Leo-Silva-get/EEG-PCB-Design-Project/images/2D_Bottom.png

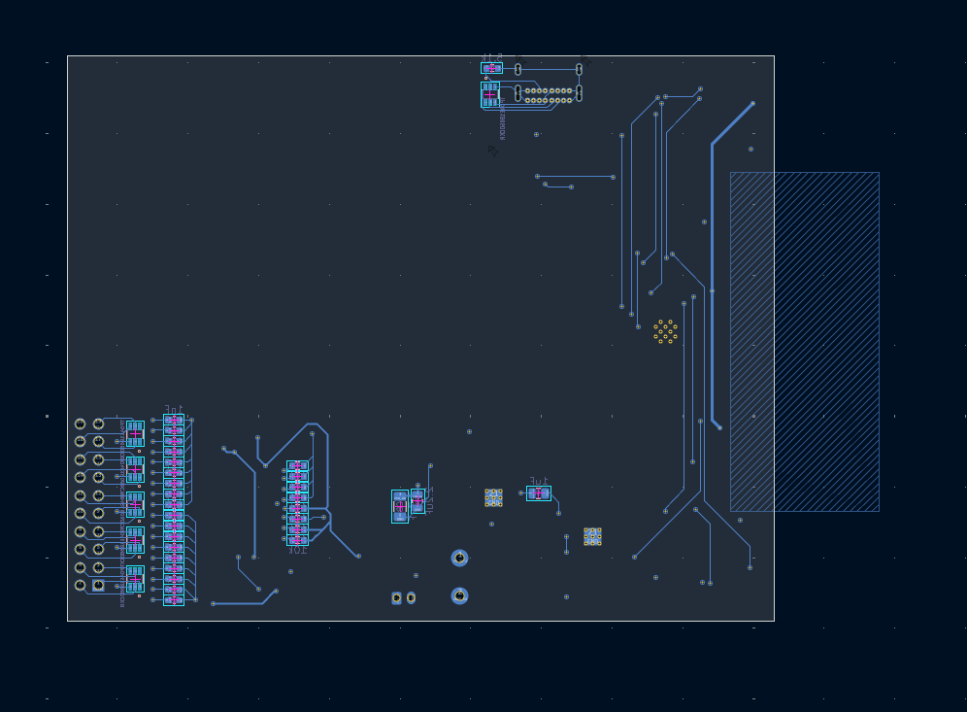
images/2D_Bottom.png
