Leo-Silva-get/EEG-PCB-Design-Project/images/2D_Top.png

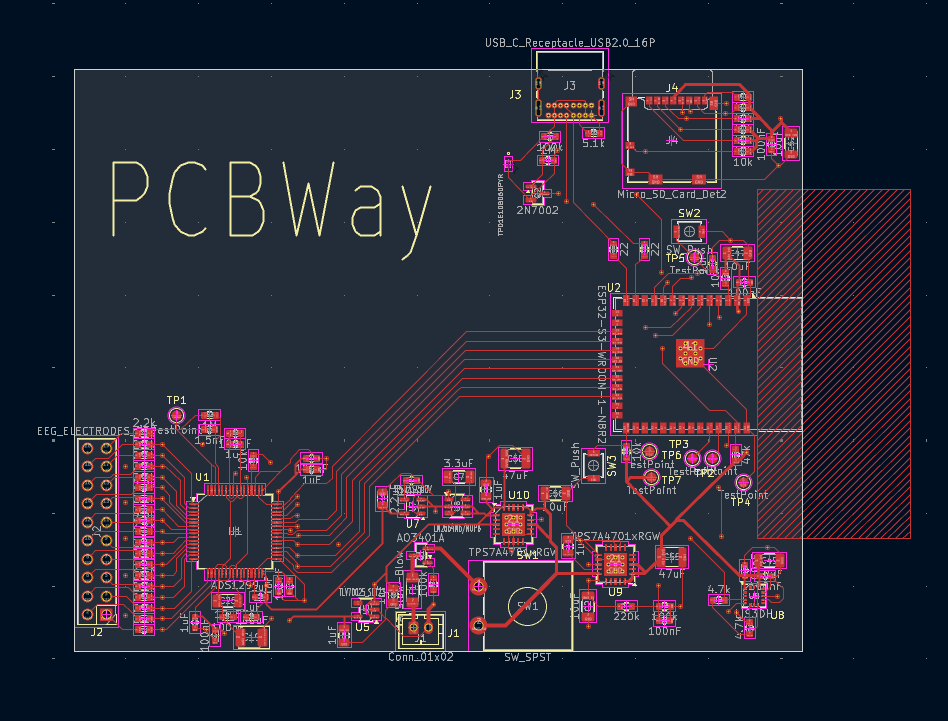
images/2D_Top.png
