Leo-Silva-get/EEG-PCB-Design-Project/images/3D_Bottom.png

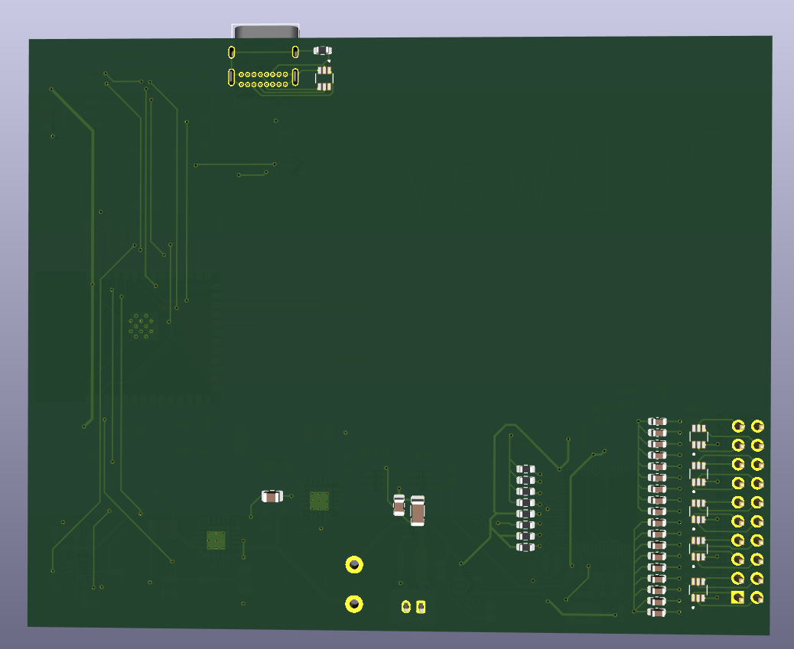
images/3D_Bottom.png
