Leo-Silva-get/EEG-PCB-Design-Project/images/3D_Top.png

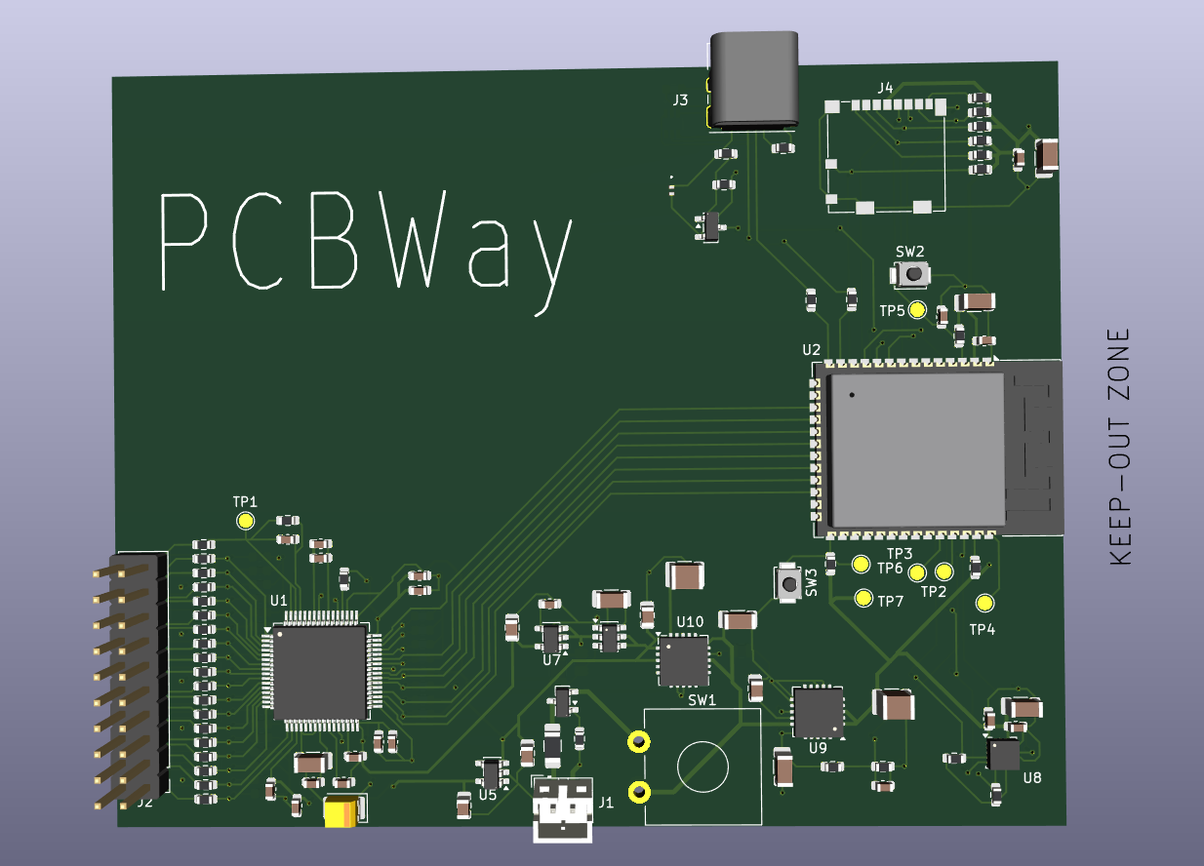
images/3D_Top.png
