Leo-Silva-get/EEG-PCB-Design-Project/images/Schematic_ADS1299_Sheet.png

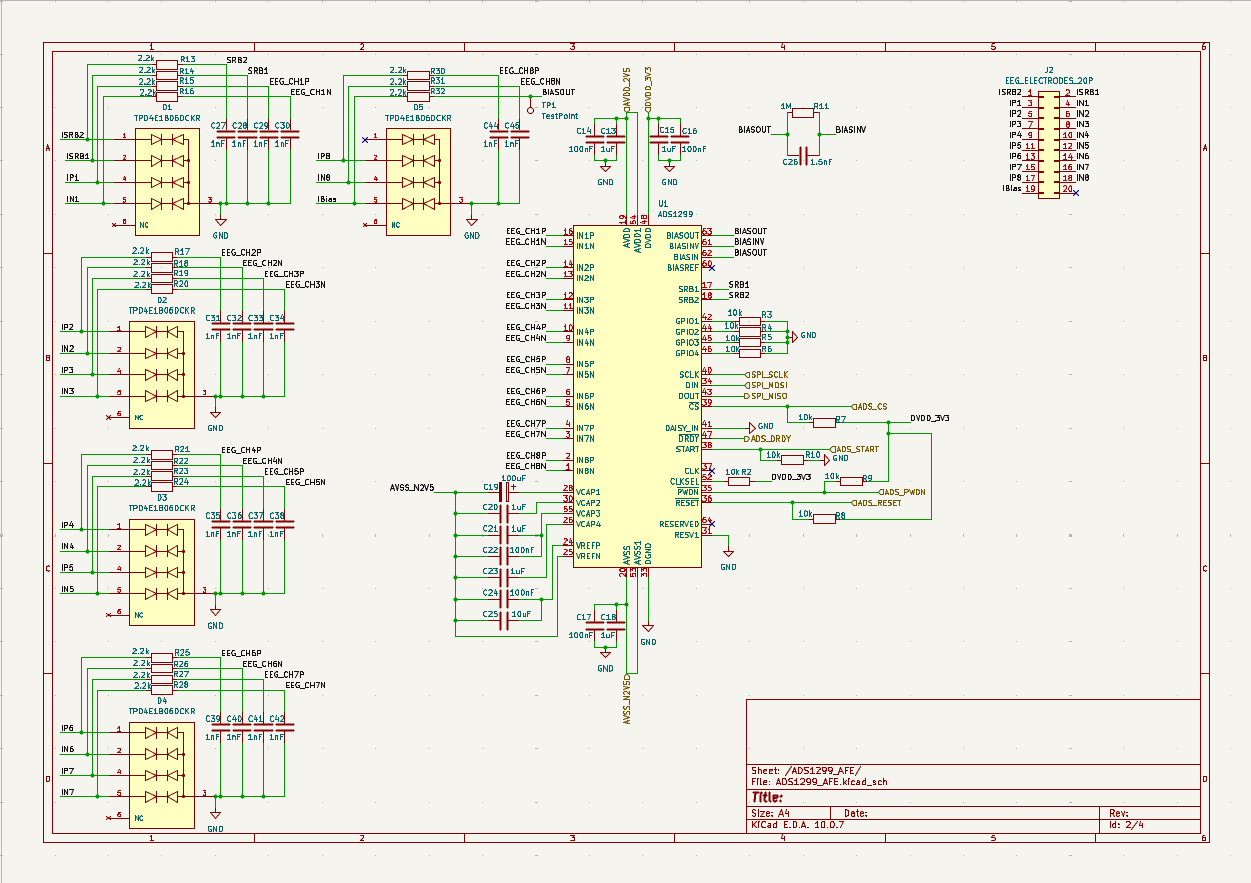
images/Schematic_ADS1299_Sheet.png
