Leo-Silva-get/EEG-PCB-Design-Project/images/Schematic_ESP32_Sheet.png

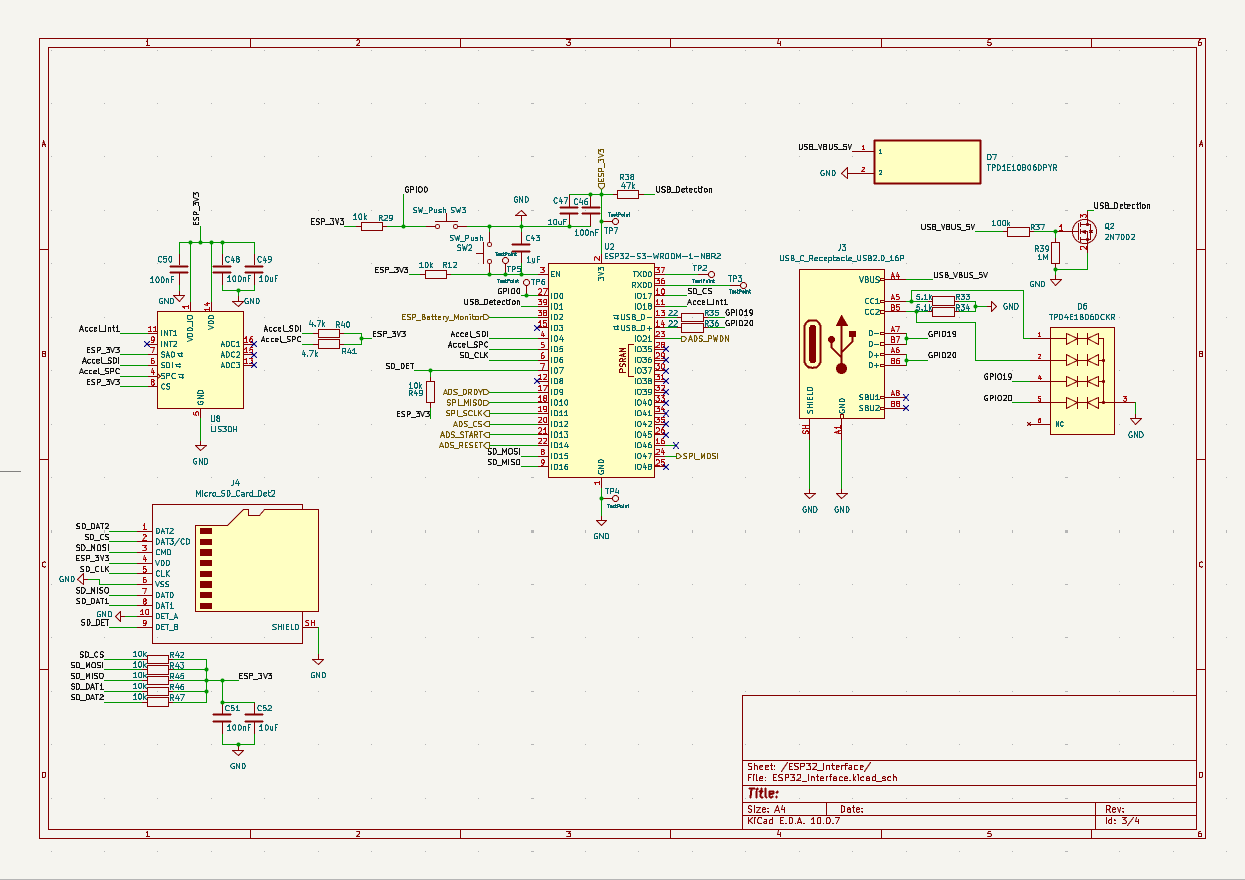
images/Schematic_ESP32_Sheet.png
