Leo-Silva-get/EEG-PCB-Design-Project/images/Schematic_PowerSupply_Sheet.png

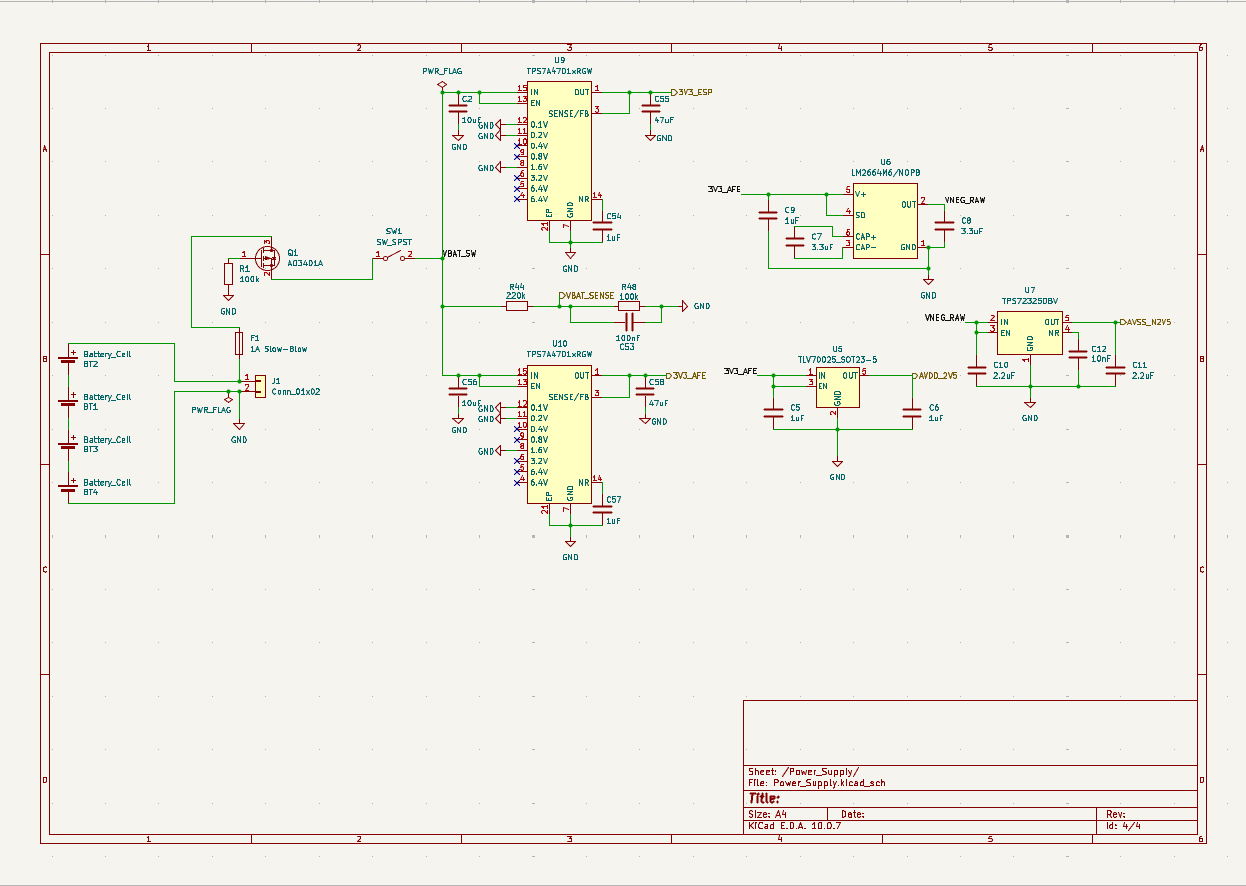
images/Schematic_PowerSupply_Sheet.png
