Leo-Silva-get/EEG-PCB-Design-Project/images/Schematic_Top_Level.png

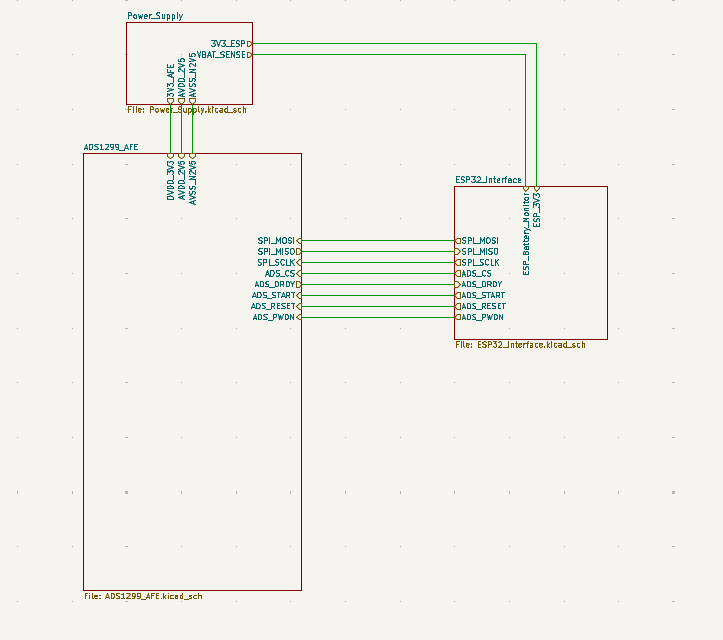
images/Schematic_Top_Level.png
