Leo-Silva-get/EEG-PCB-Design-Project/manufacturing/EEG_PROJECT_PCBWay_BOM_CLEANED.csv

Reference | Qty | Value | Manufacturer | MPN | Footprint | Assembly Type | Datasheet | Voltage Rating | Tolerance | Dielectric | Power Rating
C2, C25, C47, C49, C52, C56 | 6 | 10uF | Murata | GRM31CR71C106KAC7L | Capacitor_SMD:C_1206_3216Metric | Surface mount | https://www.digikey.com/en/products/detail/murata-electronics/GRM31CR71C106KAC7L/965995 | 16V | 10% | X7R ceramic
C5, C6, C9, C54, C57 | 5 | 1uF | TDK | C2012X7R1E105K125AB | Capacitor_SMD:C_0805_2012Metric | Surface mount | https://www.digikey.com/en/products/detail/tdk-corporation/C2012X7R1E105K125AB/513887 | 25V | 10% | X7R ceramic
C7, C8 | 2 | 3.3uF | KEMET | C1206C335K3RACTU | Capacitor_SMD:C_1206_3216Metric | Surface mount | https://www.digikey.com/en/products/detail/kemet/C1206C335K3RACTU/2215760 | 25V | 10% | X7R ceramic
C10, C11 | 2 | 2.2uF | TDK | C2012X7R1H225K125AC | Capacitor_SMD:C_0805_2012Metric | Surface mount | https://www.digikey.com/en/products/detail/tdk/C2012X7R1H225K125AC/2443446 | 50V | 10% | X7R ceramic
C12 | 1 | 10nF | Murata | GRM188R72A103KA01D | Capacitor_SMD:C_0603_1608Metric | Surface mount | https://www.digikey.com/en/products/detail/murata-electronics/GRM188R72A103KA01D/3845635 | 100V | 10% | X7R ceramic
C13, C15, C18, C20, C21, C23, C43 | 7 | 1uF | KEMET | C0603C105K4RACTU | Capacitor_SMD:C_0603_1608Metric | Surface mount | https://www.digikey.com/en/products/detail/kemet/C0603C105K4RACTU/2199788 | 16V | 10% | X7R ceramic
C14, C16, C17, C22, C24, C46, C48, C50, C51, C53 | 10 | 100nF | Murata | GRM188R72A104KA35D | Capacitor_SMD:C_0603_1608Metric | Surface mount | https://www.digikey.com/en/products/detail/murata-electronics/GRM188R72A104KA35D/702826 | 100V | 10% | X7R ceramic
C19 | 1 | 100uF | KEMET | T495B107M010ATE350 | Capacitor_Tantalum_SMD:CP_EIA-3528-21_Kemet-B | Surface mount | https://www.digikey.com/en/products/detail/kemet/T495B107M010ATE350/9642231 | 10V | 20% | Molded tantalum; ESR 0.35 Ω @100 kHz
C26 | 1 | 1.5nF | Murata | GRM1885C1H152JA01D | Capacitor_SMD:C_0603_1608Metric | Surface mount | https://www.digikey.com/en/products/detail/murata-electronics/GRM1885C1H152JA01D/587659 | 50V | 5% | C0G / NP0 ceramic
C27, C28, C29, C30, C31, C32, C33, C34, C35, C36, C37, C38, C39, C40, C41, C42, C44, C45 | 18 | 1nF | Murata | GRM1885C1H102JA01D | Capacitor_SMD:C_0603_1608Metric | Surface mount | https://www.digikey.com/en/products/detail/murata-electronics/GRM1885C1H102JA01D/587655 | 50V | 5% | C0G / NP0 ceramic
C55, C58 | 2 | 47uF | Samsung Electro-Mechanics | CL32A476KOJNNNE | Capacitor_SMD:C_1210_3225Metric | Surface mount | https://www.digikey.com/en/products/detail/samsung-electro-mechanics/CL32A476KOJNNNE/3889034 | 16V | 10% | X5R ceramic
D1, D2, D3, D4, D5, D6 | 6 | TPD4E1B06DCKR | Texas Instruments | TPD4E1B06DCKR | Library:TVS_TPD4E1B06DCKR | Surface mount | https://www.ti.com/product/TPD4E1B06 |  |  | ESD / TVS
D7 | 1 | TPD1E10B06DPYR | Texas Instruments | TPD1E10B06DPYR | Library:DIO_TPD1E10B06DPYR | Surface mount | https://www.ti.com/product/TPD1E10B06 |  |  | ESD / TVS
F1 | 1 | 1A Slow-Blow | Bourns | SF-1206S100-2 | Library:SF-1206S100-2 | Surface mount | https://www.bourns.com/docs/product-datasheets/sf-1206s.pdf |  |  | Slow-blow, non-resettable fuse
J1 | 1 | Conn_01x02 | JST | B2B-PH-K-S(LF)(SN) | Connector_JST:JST_PH_B2B-PH-K_1x02_P2.00mm_Vertical | Through-hole | https://www.digikey.com/en/products/detail/jst-sales-america-inc/B2B-PH-K-S-LF-SN/926611
J2 | 1 | EEG_ELECTRODES_20P | Samtec | TSW-110-07-G-D | Connector_PinHeader_2.54mm:PinHeader_2x10_P2.54mm_Vertical | Through-hole | https://www.digikey.com/en/products/detail/samtec-inc/TSW-110-07-G-D/1101267
J3 | 1 | USB_C_Receptacle_USB2.0_16P | GCT | USB4085-GF-A | Connector_USB:USB_C_Receptacle_GCT_USB4085 | Through-hole | https://www.digikey.com/en/products/detail/gct/USB4085-GF-A/9859662
J4 | 1 | Micro_SD_Card_Det2 | Molex | 104031-0811 | Connector_Card:microSD_HC_Molex_104031-0811 | Surface mount | https://www.digikey.com/en/products/detail/molex/1040310811/2370379
Q1 | 1 | AO3401A | Alpha & Omega Semiconductor | AO3401A | Package_TO_SOT_SMD:SOT-23 | Surface mount | https://www.digikey.com/en/products/detail/alpha-omega-semiconductor-inc/AO3401A/1855943 |  |  | SOT-23 MOSFET
Q2 | 1 | 2N7002 | Onsemi | 2N7002LT1G | Package_TO_SOT_SMD:SOT-23 | Surface mount | https://www.digikey.com/en/products/detail/onsemi/2N7002LT1G/917791 |  |  | SOT-23 MOSFET
R1, R37, R48 | 3 | 100k | YAGEO | RC0603FR-07100KL | Resistor_SMD:R_0603_1608Metric | Surface mount | https://www.digikey.com/en/products/detail/yageo/RC0603FR-07100KL/726889 | Max working voltage per YAGEO RC datasheet | ±1% | Thick-film chip resistor | 0.1 W
R2, R3, R4, R5, R6, R7, R8, R9, R10, R12, R29, R42, R43, R45, R46, R47, R49 | 17 | 10k | YAGEO | RC0603FR-0710KL | Resistor_SMD:R_0603_1608Metric | Surface mount | https://www.digikey.com/en/products/detail/yageo/RC0603FR-0710KL/729827 | Max working voltage per YAGEO RC datasheet | ±1% | Thick-film chip resistor | 0.1 W
R11, R39 | 2 | 1M | YAGEO | RC0603FR-071ML | Resistor_SMD:R_0603_1608Metric | Surface mount | https://www.digikey.com/en/products/detail/yageo/RC0603FR-071ML/729791 | Max working voltage per YAGEO RC datasheet | ±1% | Thick-film chip resistor | 0.1 W
R13, R14, R15, R16, R17, R18, R19, R20, R21, R22, R23, R24, R25, R26, R27, R28, R30, R31, R32 | 19 | 2.2k | YAGEO | RC0603FR-072K2L | Resistor_SMD:R_0603_1608Metric | Surface mount | https://www.digikey.com/en/products/detail/yageo/RC0603FR-072K2L/727016 | Max working voltage per YAGEO RC datasheet | ±1% | Thick-film chip resistor | 0.1 W
R33, R34 | 2 | 5.1k | YAGEO | RC0603FR-075K1L | Resistor_SMD:R_0603_1608Metric | Surface mount | https://www.digikey.com/en/products/detail/yageo/RC0603FR-075K1L/727268 | Max working voltage per YAGEO RC datasheet | ±1% | Thick-film chip resistor | 0.1 W
R35, R36 | 2 | 22 | YAGEO | RC0603FR-0722RL | Resistor_SMD:R_0603_1608Metric | Surface mount | https://www.digikey.com/en/products/detail/yageo/RC0603FR-0722RL/727055 | Max working voltage per YAGEO RC datasheet | ±1% | Thick-film chip resistor | 0.1 W
R38 | 1 | 47k | YAGEO | RC0603FR-0747KL | Resistor_SMD:R_0603_1608Metric | Surface mount | https://www.digikey.com/en/products/detail/yageo/RC0603FR-0747KL/730200 | Max working voltage per YAGEO RC datasheet | ±1% | Thick-film chip resistor | 0.1 W
R40, R41 | 2 | 4.7k | YAGEO | RC0603FR-074K7L | Resistor_SMD:R_0603_1608Metric | Surface mount | https://www.digikey.com/en/products/detail/yageo/RC0603FR-074K7L/727212 | Max working voltage per YAGEO RC datasheet | ±1% | Thick-film chip resistor | 0.1 W
R44 | 1 | 220k | YAGEO | RC0603FR-07220KL | Resistor_SMD:R_0603_1608Metric | Surface mount | https://www.digikey.com/en/products/detail/yageo/RC0603FR-07220KL/727062 | Max working voltage per YAGEO RC datasheet | ±1% | Thick-film chip resistor | 0.1 W
SW1 | 1 | SW_SPST | CW Industries | GPTS203211B | Button_Switch_THT:SW_CW_GPTS203211B | Through-hole | https://www.digikey.com/en/products/detail/cw-industries/GPTS203211B/CW181-ND/3190590 |  |  | Electromechanical switch
SW2, SW3 | 2 | SW_Push | Aratas (formerly Omron Components) | B3U-1000P | Button_Switch_SMD:SW_SPST_B3U-1000P | Surface mount | https://www.digikey.com/en/products/detail/omron-electronics-inc-emc-div/B3U-1000P/1534338 |  |  | Electromechanical switch
U1 | 1 | ADS1299 | Texas Instruments | ADS1299IPAG | Package_QFP:TQFP-64_10x10mm_P0.5mm | Surface mount | https://www.ti.com/lit/ds/symlink/ads1299.pdf
U2 | 1 | ESP32-S3-WROOM-1-N8R2 | Espressif | ESP32-S3-WROOM-1-N8R2 | RF_Module:ESP32-S3-WROOM-1 | Surface mount | https://www.espressif.com/sites/default/files/documentation/esp32-s3-wroom-1_wroom-1u_datasheet_en.pdf
U5 | 1 | TLV70025_SOT23-5 | Texas Instruments | TLV70025DDCR | Package_TO_SOT_SMD:SOT-23-5 | Surface mount | https://www.digikey.com/en/products/detail/texas-instruments/TLV70025DDCR/2261946
U6 | 1 | LM2664M6/NOPB | Texas Instruments | LM2664M6/NOPB | Package_TO_SOT_SMD:SOT-23-6 | Surface mount | https://www.ti.com/lit/ds/symlink/lm2664.pdf
U7 | 1 | TPS72325DBV | Texas Instruments | TPS72325DBVR | Package_TO_SOT_SMD:SOT-23-5 | Surface mount | https://www.ti.com/lit/ds/symlink/tps723.pdf
U8 | 1 | LIS3DH | STMicroelectronics | LIS3DHTR | Package_LGA:LGA-16_3x3mm_P0.5mm_LayoutBorder3x5y | Surface mount | https://www.digikey.com/en/products/detail/stmicroelectronics/LIS3DHTR/2334338
U9, U10 | 2 | TPS7A4701xRGW | Texas Instruments | TPS7A4701RGWR | Package_DFN_QFN:Texas_RGW0020A_VQFN-20-1EP_5x5mm_P0.65mm_EP3.15x3.15mm_ThermalVias | Surface mount | https://www.ti.com/product/TPS7A47/part-details/TPS7A4701RGWR
