Leo-Silva-get/EEG-PCB-Design-Project/manufacturing/EEG_PROJECT-B_Fab.pdf

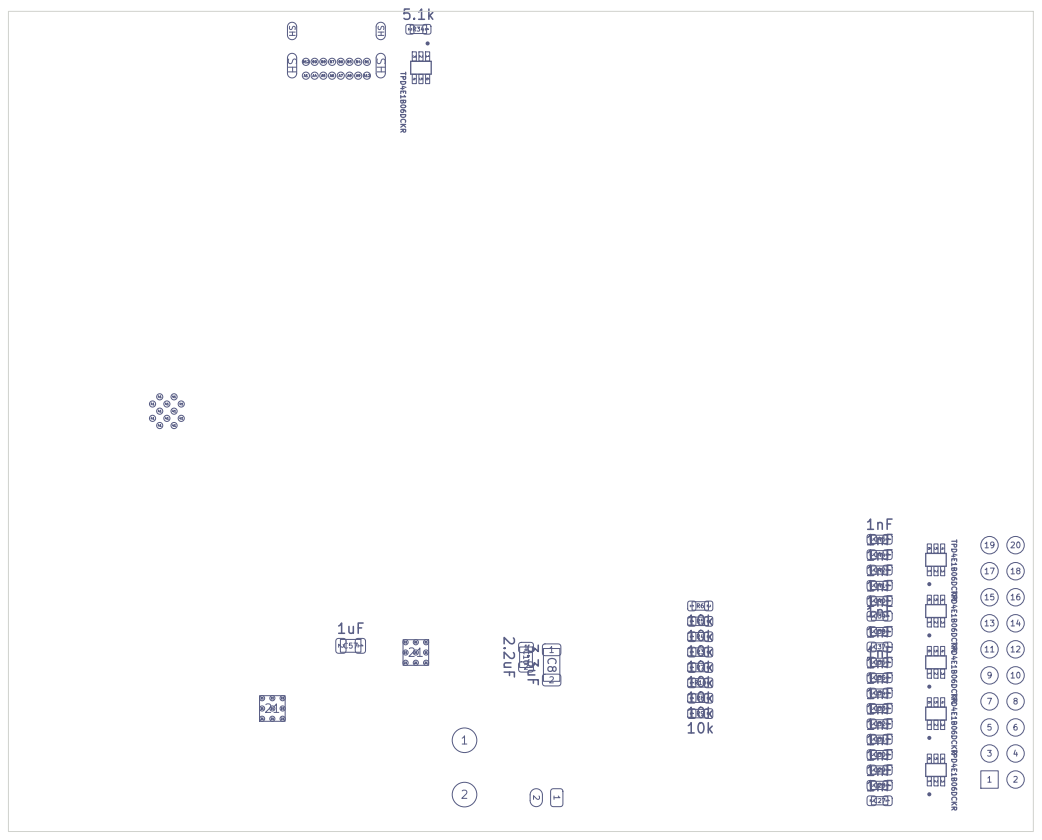
[picture p9: page 1]
