Leo-Silva-get/EEG-PCB-Design-Project/manufacturing/EEG_PROJECT-F_Fab.pdf

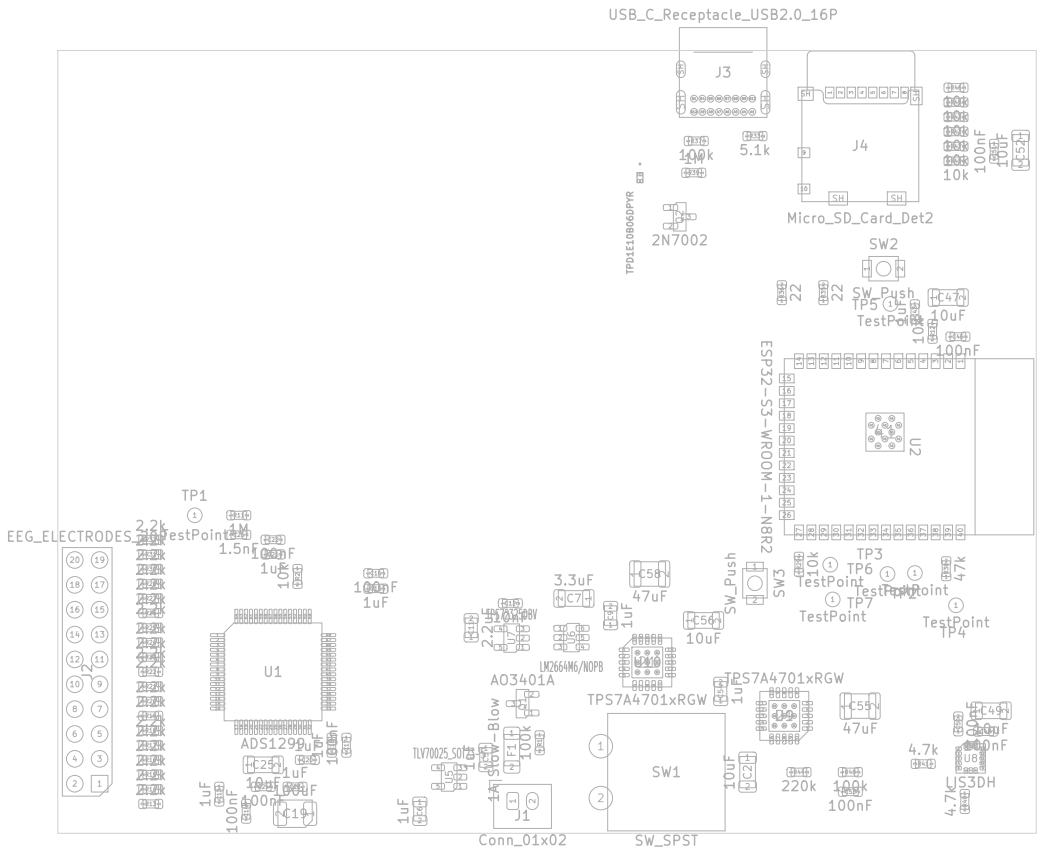
[picture p10: page 1]
