Leo-Silva-get/EEG-PCB-Design-Project/manufacturing/EEG_Project.pdf

J3


C38 5.1k

R34
