Leo-Silva-get/EEG-PCB-Design-Project/hardware/EEG_PROJECT.kicad_pcb

## KiCad design hardware/EEG_PROJECT.kicad_pcb (2026-11-08)

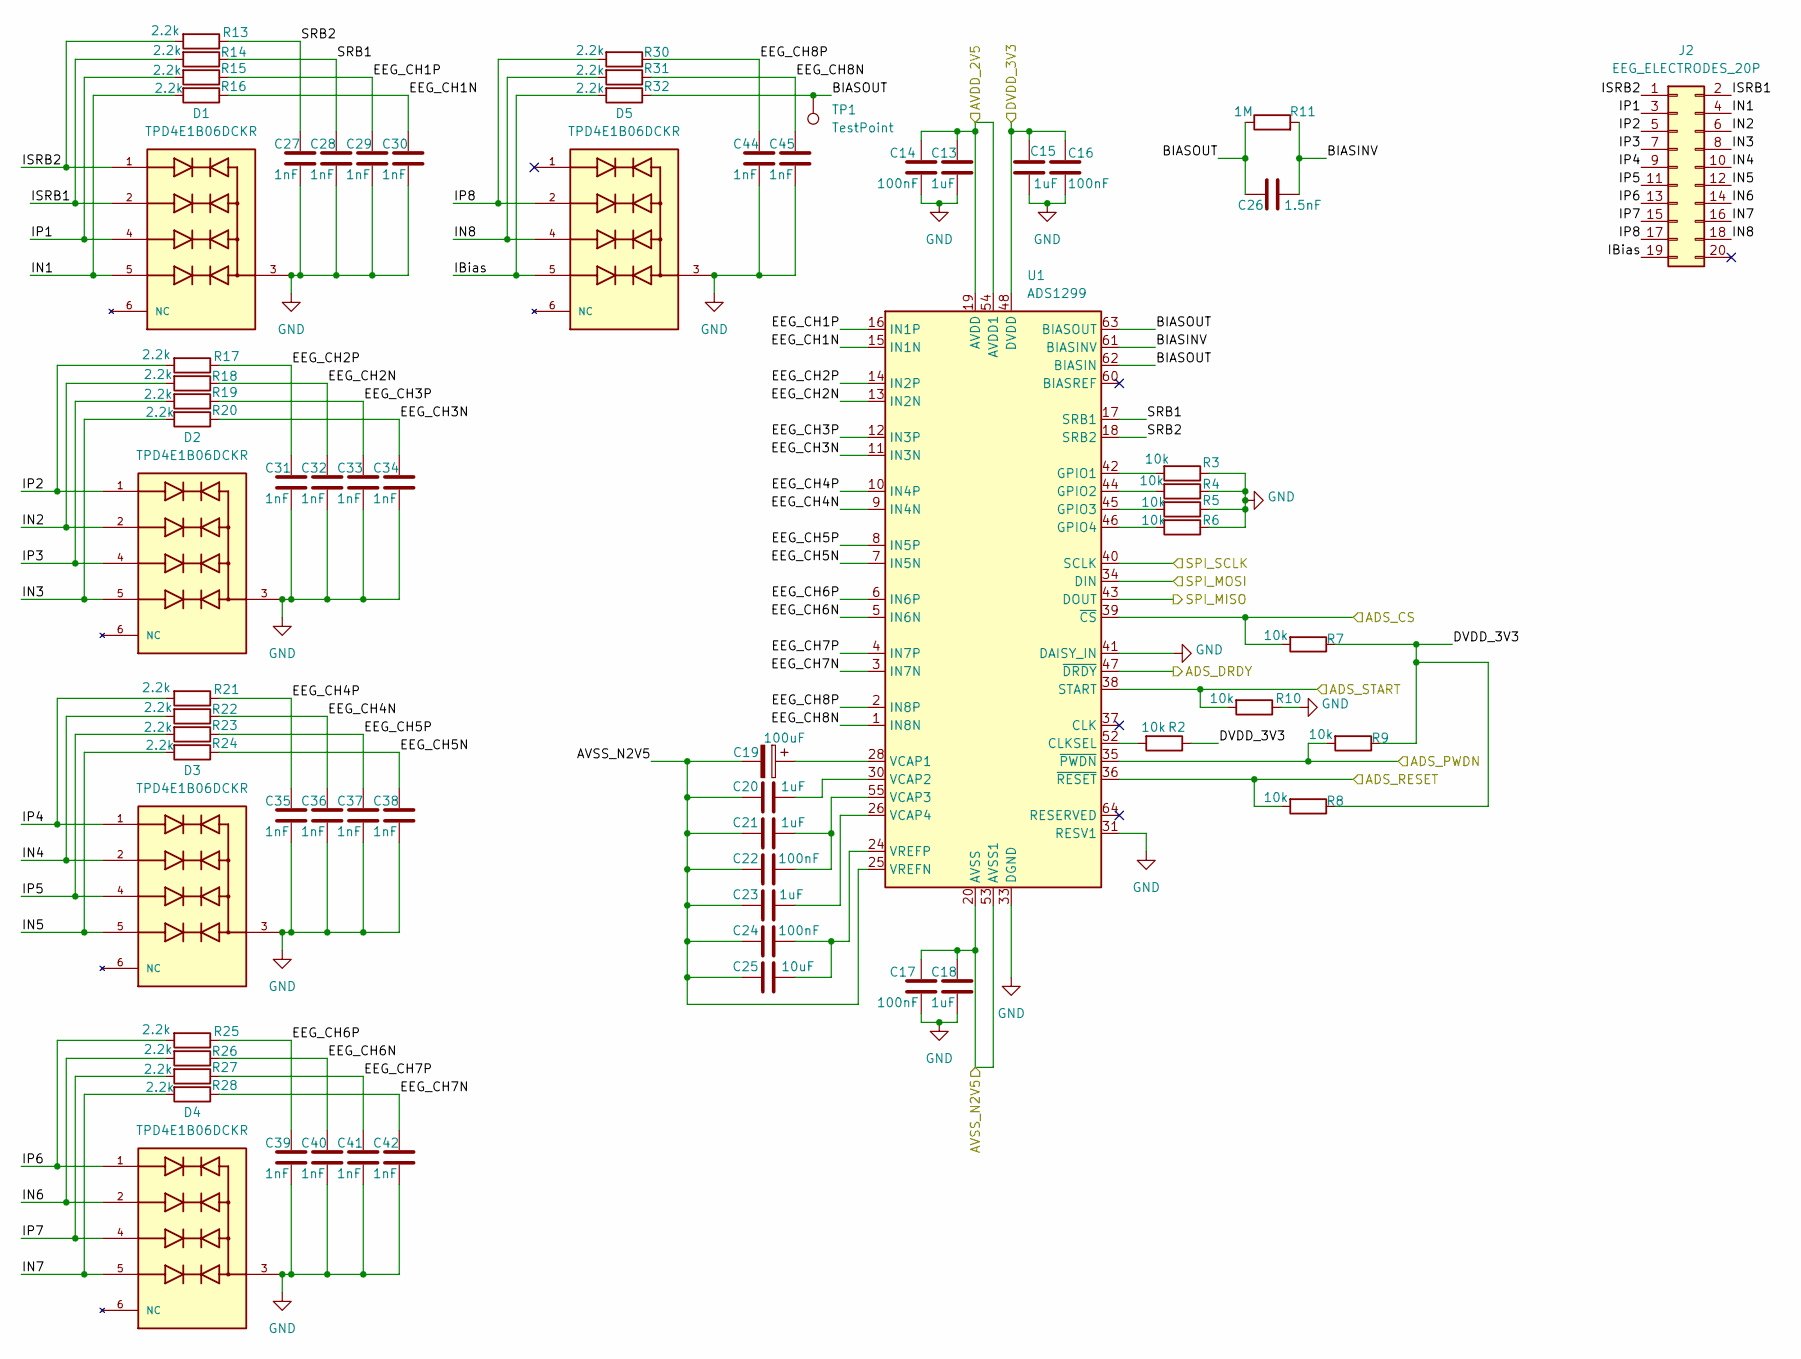
[picture p11: schematic ADS1299_AFE.kicad_sch]

Parts:
C13, C15, C18, C20, C21, C23: 1uF; C_0603_1608Metric; Tolerance 10%; Voltage rating 16V; MPN C0603C105K4RACTU
C14, C16, C17, C22, C24: 100nF; C_0603_1608Metric; Tolerance 10%; Voltage rating 100V; MPN GRM188R72A104KA35D
C19: 100uF; CP_EIA-3528-21_Kemet-B; Tolerance 20%; Voltage rating 10V; MPN T495B107M010ATE350
C25: 10uF; C_1206_3216Metric; Tolerance 10%; Voltage rating 16V; MPN GRM31CR71C106KAC7L
C26: 1.5nF; C_0603_1608Metric; Tolerance 5%; Voltage rating 50V; MPN GRM1885C1H152JA01D
C27, C28, C29, C30, C31, C32, C33, C34, C35, C36, C37, C38, C39, C40, C41, C42, C44, C45: 1nF; C_0603_1608Metric; Tolerance 5%; Voltage rating 50V; MPN GRM1885C1H102JA01D
D1, D2, D3, D4, D5: TPD4E1B06DCKR; TVS_TPD4E1B06DCKR; PARTREV C
J2: EEG_ELECTRODES_20P; PinHeader_2x10_P2.54mm_Vertical; MPN TSW-110-07-G-D
R2, R3, R4, R5, R6, R7, R8, R9, R10: 10k; R_0603_1608Metric; Power Rating 0.1 W; Tolerance ±1%; MPN RC0603FR-0710KL
R11: 1M; R_0603_1608Metric; Power Rating 0.1 W; Tolerance ±1%; MPN RC0603FR-071ML
R13, R14, R15, R16, R17, R18, R19, R20, R21, R22, R23, R24, R25, R26, R27, R28, R30, R31, R32: 2.2k; R_0603_1608Metric; Power Rating 0.1 W; Tolerance ±1%; MPN RC0603FR-072K2L
TP1: TestPoint; TestPoint_Pad_D1.5mm; MPN N/A
U1: ADS1299; TQFP-64_10x10mm_P0.5mm; MPN ADS1299IPAG

Connections:
/ADS1299_AFE/ADS_CS: R7.2, U1.39 (~CS); also elsewhere on the board
/ADS1299_AFE/ADS_DRDY: U1.47 (~DRDY); also elsewhere on the board
/ADS1299_AFE/ADS_PWDN: R9.2, U1.35 (~PWDN); also elsewhere on the board
/ADS1299_AFE/ADS_RESET: R8.2, U1.36 (~RESET); also elsewhere on the board
/ADS1299_AFE/ADS_START: R10.2, U1.38 (START); also elsewhere on the board
/ADS1299_AFE/AVDD_2V5: C13.1, C14.1, U1.19 (AVDD), U1.21 (AVDD), U1.22 (AVDD), U1.54 (AVDD1), U1.56 (AVDD), U1.59 (AVDD); also elsewhere on the board
/ADS1299_AFE/AVSS_N2V5: C17.1, C18.1, C19.2, C20.1, C21.1, C22.1, C23.1, C24.1, C25.1, U1.20 (AVSS), U1.23 (AVSS), U1.25 (VREFN), U1.32 (AVSS), U1.53 (AVSS1), U1.57 (AVSS), U1.58 (AVSS); also elsewhere on the board
/ADS1299_AFE/BIASINV: C26.2, R11.2, U1.61 (BIASINV)
/ADS1299_AFE/BIASOUT: C26.1, R11.1, R32.1, TP1.1 (1_1), U1.62 (BIASIN), U1.63 (BIASOUT)
/ADS1299_AFE/DVDD_3V3: C15.1, C16.1, R2.1, R7.1, R8.1, R9.1, U1.48 (DVDD), U1.50 (DVDD); also elsewhere on the board
/ADS1299_AFE/EEG_CH1N: C30.1, R16.1, U1.15 (IN1N)
/ADS1299_AFE/EEG_CH1P: C29.1, R15.1, U1.16 (IN1P)
/ADS1299_AFE/EEG_CH2N: C32.1, R18.1, U1.13 (IN2N)
/ADS1299_AFE/EEG_CH2P: C31.1, R17.1, U1.14 (IN2P)
/ADS1299_AFE/EEG_CH3N: C34.1, R20.1, U1.11 (IN3N)
/ADS1299_AFE/EEG_CH3P: C33.1, R19.1, U1.12 (IN3P)
/ADS1299_AFE/EEG_CH4N: C36.1, R22.1, U1.9 (IN4N)
/ADS1299_AFE/EEG_CH4P: C35.1, R21.1, U1.10 (IN4P)
/ADS1299_AFE/EEG_CH5N: C38.1, R24.1, U1.7 (IN5N)
/ADS1299_AFE/EEG_CH5P: C37.1, R23.1, U1.8 (IN5P)
/ADS1299_AFE/EEG_CH6N: C40.1, R26.1, U1.5 (IN6N)
/ADS1299_AFE/EEG_CH6P: C39.1, R25.1, U1.6 (IN6P)
/ADS1299_AFE/EEG_CH7N: C42.1, R28.1, U1.3 (IN7N)
/ADS1299_AFE/EEG_CH7P: C41.1, R27.1, U1.4 (IN7P)
/ADS1299_AFE/EEG_CH8N: C45.1, R31.1, U1.1 (IN8N)
/ADS1299_AFE/EEG_CH8P: C44.1, R30.1, U1.2 (IN8P)
/ADS1299_AFE/IBias: D5.5, J2.19, R32.2
/ADS1299_AFE/IN1: D1.5, J2.4, R16.2
/ADS1299_AFE/IN2: D2.2, J2.6, R18.2
/ADS1299_AFE/IN3: D2.5, J2.8, R20.2
/ADS1299_AFE/IN4: D3.2, J2.10, R22.2
/ADS1299_AFE/IN5: D3.5, J2.12, R24.2
/ADS1299_AFE/IN6: D4.2, J2.14, R26.2
/ADS1299_AFE/IN7: D4.5, J2.16, R28.2
/ADS1299_AFE/IN8: D5.4, J2.18, R31.2
/ADS1299_AFE/IP1: D1.4, J2.3, R15.2
/ADS1299_AFE/IP2: D2.1, J2.5, R17.2
/ADS1299_AFE/IP3: D2.4, J2.7, R19.2
/ADS1299_AFE/IP4: D3.1, J2.9, R21.2
/ADS1299_AFE/IP5: D3.4, J2.11, R23.2
/ADS1299_AFE/IP6: D4.1, J2.13, R25.2
/ADS1299_AFE/IP7: D4.4, J2.15, R27.2
/ADS1299_AFE/IP8: D5.2, J2.17, R30.2
/ADS1299_AFE/ISRB1: D1.2, J2.2, R14.2
/ADS1299_AFE/ISRB2: D1.1, J2.1, R13.2
/ADS1299_AFE/SPI_MISO: U1.43 (DOUT); also elsewhere on the board
/ADS1299_AFE/SPI_MOSI: U1.34 (DIN); also elsewhere on the board
/ADS1299_AFE/SPI_SCLK: U1.40 (SCLK); also elsewhere on the board
/ADS1299_AFE/SRB1: C28.1, R14.1, U1.17 (SRB1)
/ADS1299_AFE/SRB2: C27.1, R13.1, U1.18 (SRB2)
GND: C13.2, C14.2, C15.2, C16.2, C17.2, C18.2, C27.2, C28.2, C29.2, C30.2, C31.2, C32.2, C33.2, C34.2, C35.2, C36.2, C37.2, C38.2, C39.2, C40.2, C41.2, C42.2, C44.2, C45.2, D1.3, D2.3, D3.3, D4.3, D5.3, R3.1, R4.1, R5.1, R6.1, R10.1, U1.31 (RESV1), U1.33 (DGND), U1.41 (DAISY_IN), U1.49 (DGND), U1.51 (DGND); also elsewhere on the board
unnamed: R2.2, U1.52 (CLKSEL)
unnamed: R3.2, U1.42 (GPIO1)
unnamed: R4.2, U1.44 (GPIO2)
unnamed: R5.2, U1.45 (GPIO3)
unnamed: R6.2, U1.46 (GPIO4)
unnamed: C19.1, U1.28 (VCAP1)
unnamed: C20.2, U1.30 (VCAP2)
unnamed: C21.2, C22.2, U1.55 (VCAP3)
unnamed: C23.2, U1.26 (VCAP4)
unnamed: C24.2, C25.2, U1.24 (VREFP)

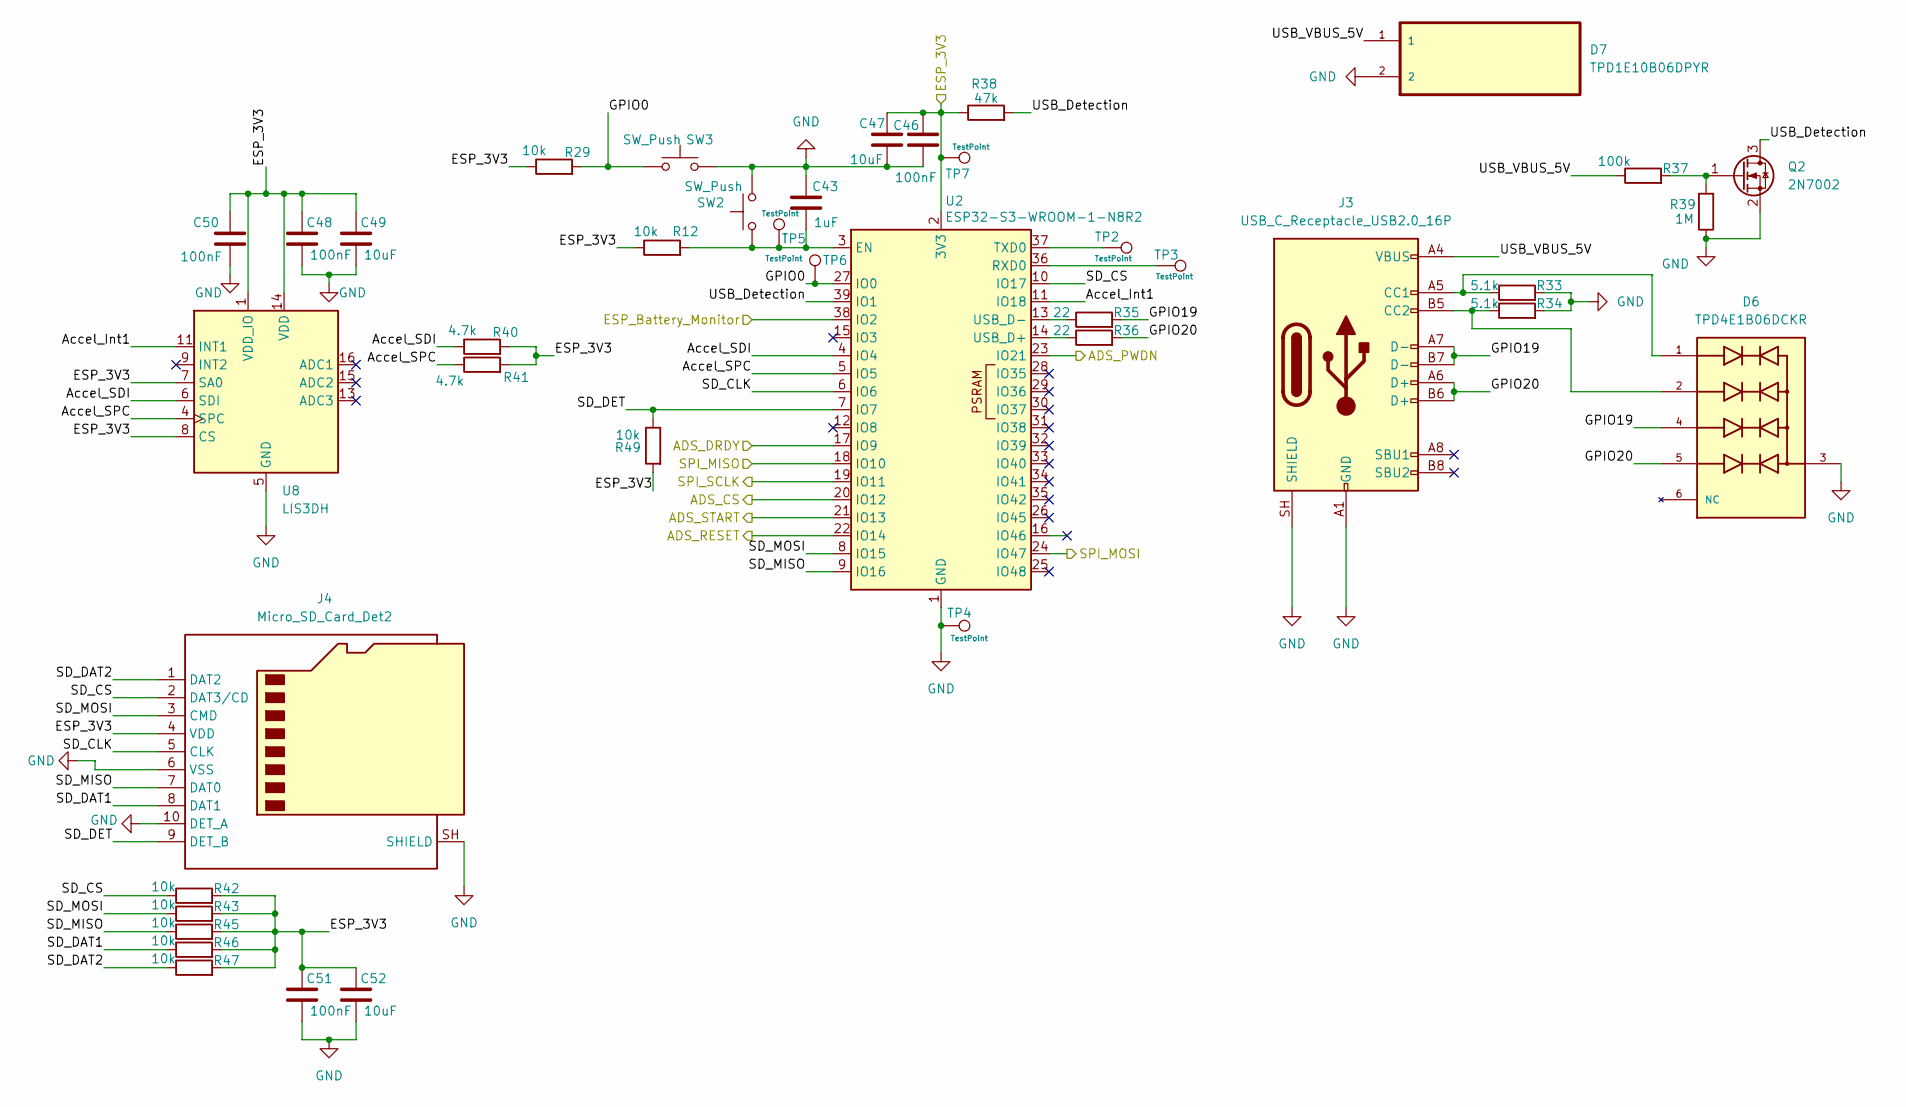
[picture p12: schematic ESP32_Interface.kicad_sch]

Parts:
C43: 1uF; C_0603_1608Metric; Tolerance 10%; Voltage rating 16V; MPN C0603C105K4RACTU
C46, C48, C50, C51: 100nF; C_0603_1608Metric; Tolerance 10%; Voltage rating 100V; MPN GRM188R72A104KA35D
C47, C49, C52: 10uF; C_1206_3216Metric; Tolerance 10%; Voltage rating 16V; MPN GRM31CR71C106KAC7L
D6: TPD4E1B06DCKR; TVS_TPD4E1B06DCKR; PARTREV C
D7: TPD1E10B06DPYR; DIO_TPD1E10B06DPYR; MPN TPD1E10B06DPYR; DigiKey_Part_Number 296-41842-1-ND
J3: USB_C_Receptacle_USB2.0_16P; USB_C_Receptacle_GCT_USB4085; MPN USB4085-GF-A
J4: Micro_SD_Card_Det2; microSD_HC_Molex_104031-0811; MPN 104031-0811
Q2: 2N7002; SOT-23; MPN 2N7002LT1G
R12, R29, R42, R43, R45, R46, R47, R49: 10k; R_0603_1608Metric; Power Rating 0.1 W; Tolerance ±1%; MPN RC0603FR-0710KL
R33, R34: 5.1k; R_0603_1608Metric; Power Rating 0.1 W; Tolerance ±1%; MPN RC0603FR-075K1L
R35, R36: 22; R_0603_1608Metric; Power Rating 0.1 W; Tolerance ±1%; MPN RC0603FR-0722RL
R37: 100k; R_0603_1608Metric; Power Rating 0.1 W; Tolerance ±1%; MPN RC0603FR-07100KL
R38: 47k; R_0603_1608Metric; Power Rating 0.1 W; Tolerance ±1%; MPN RC0603FR-0747KL
R39: 1M; R_0603_1608Metric; Power Rating 0.1 W; Tolerance ±1%; MPN RC0603FR-071ML
R40, R41: 4.7k; R_0603_1608Metric; Power Rating 0.1 W; Tolerance ±1%; MPN RC0603FR-074K7L
SW2, SW3: SW_Push; SW_SPST_B3U-1000P; MPN B3U-1000P
TP2, TP3, TP4, TP5, TP6, TP7: TestPoint; TestPoint_Pad_D1.5mm; MPN N/A
U2: ESP32-S3-WROOM-1-N8R2; ESP32-S3-WROOM-1; MPN ESP32-S3-WROOM-1-N8R2
U8: LIS3DH; LGA-16_3x3mm_P0.5mm_LayoutBorder3x5y; MPN LIS3DHTR

Connections:
/ADS1299_AFE/ADS_CS: U2.20 (IO12); also elsewhere on the board
/ADS1299_AFE/ADS_DRDY: U2.17 (IO9); also elsewhere on the board
/ADS1299_AFE/ADS_PWDN: U2.23 (IO21); also elsewhere on the board
/ADS1299_AFE/ADS_RESET: U2.22 (IO14); also elsewhere on the board
/ADS1299_AFE/ADS_START: U2.21 (IO13); also elsewhere on the board
/ADS1299_AFE/SPI_MISO: U2.18 (IO10); also elsewhere on the board
/ADS1299_AFE/SPI_MOSI: U2.24 (IO47); also elsewhere on the board
/ADS1299_AFE/SPI_SCLK: U2.19 (IO11); also elsewhere on the board
/ESP32_Interface/Accel_Int1: U2.11 (IO18), U8.11 (INT1)
/ESP32_Interface/Accel_SDI: R40.1, U2.4 (IO4), U8.6 (SDI)
/ESP32_Interface/Accel_SPC: R41.1, U2.5 (IO5), U8.4 (SPC)
/ESP32_Interface/ESP_3V3: C46.1, C47.1, C48.1, C49.1, C50.1, C51.1, C52.1, J4.4 (VDD), R12.1, R29.1, R38.1, R40.2, R41.2, R42.2, R43.2, R45.2, R46.2, R47.2, R49.2, TP7.1 (1_1), U2.2 (3V3), U8.1 (VDD_IO), U8.7 (SA0), U8.8 (CS), U8.14 (VDD); also elsewhere on the board
/ESP32_Interface/ESP_Battery_Monitor: U2.38 (IO2); also elsewhere on the board
/ESP32_Interface/GPIO0: R29.2, SW3.1, TP6.1 (1_1), U2.27 (IO0)
/ESP32_Interface/GPIO19: D6.4, J3.A7 (D-), J3.B7 (D-), R35.2
/ESP32_Interface/GPIO20: D6.5, J3.A6 (D+), J3.B6 (D+), R36.2
/ESP32_Interface/SD_CLK: J4.5 (CLK), U2.6 (IO6)
/ESP32_Interface/SD_CS: J4.2 (DAT3/CD), R42.1, U2.10 (IO17)
/ESP32_Interface/SD_DAT1: J4.8 (DAT1), R46.1
/ESP32_Interface/SD_DAT2: J4.1 (DAT2), R47.1
/ESP32_Interface/SD_DET: J4.9 (DET_B), R49.1, U2.7 (IO7)
/ESP32_Interface/SD_MISO: J4.7 (DAT0), R45.1, U2.9 (IO16)
/ESP32_Interface/SD_MOSI: J4.3 (CMD), R43.1, U2.8 (IO15)
/ESP32_Interface/USB_Detection: Q2.3 (D), R38.2, U2.39 (IO1)
/ESP32_Interface/USB_VBUS_5V: D7.1, J3.A4 (VBUS), J3.A9 (VBUS), J3.B4 (VBUS), J3.B9 (VBUS), R37.1
GND: C43.1, C46.2, C47.2, C48.2, C49.2, C50.2, C51.2, C52.2, D6.3, D7.2, J3.A1 (GND), J3.A12 (GND), J3.B1 (GND), J3.B12 (GND), J3.SH (SHIELD), J4.6 (VSS), J4.10 (DET_A), J4.SH (SHIELD), Q2.2 (S), R33.2, R34.2, R39.1, SW2.2, SW3.2, TP4.1 (1_1), U2.1 (GND), U2.40 (GND), U2.41 (GND), U8.5 (GND), U8.10 (GND), U8.12 (GND); also elsewhere on the board
unnamed: D6.1, J3.A5 (CC1), R33.1
unnamed: D6.2, J3.B5 (CC2), R34.1
unnamed: Q2.1 (G), R37.2, R39.2
unnamed: C43.2, R12.2, SW2.1, TP5.1 (1_1), U2.3 (EN)
unnamed: TP3.1 (1_1), U2.36 (RXD0)
unnamed: TP2.1 (1_1), U2.37 (TXD0)
unnamed: R36.1, U2.14 (USB_D+)
unnamed: R35.1, U2.13 (USB_D-)

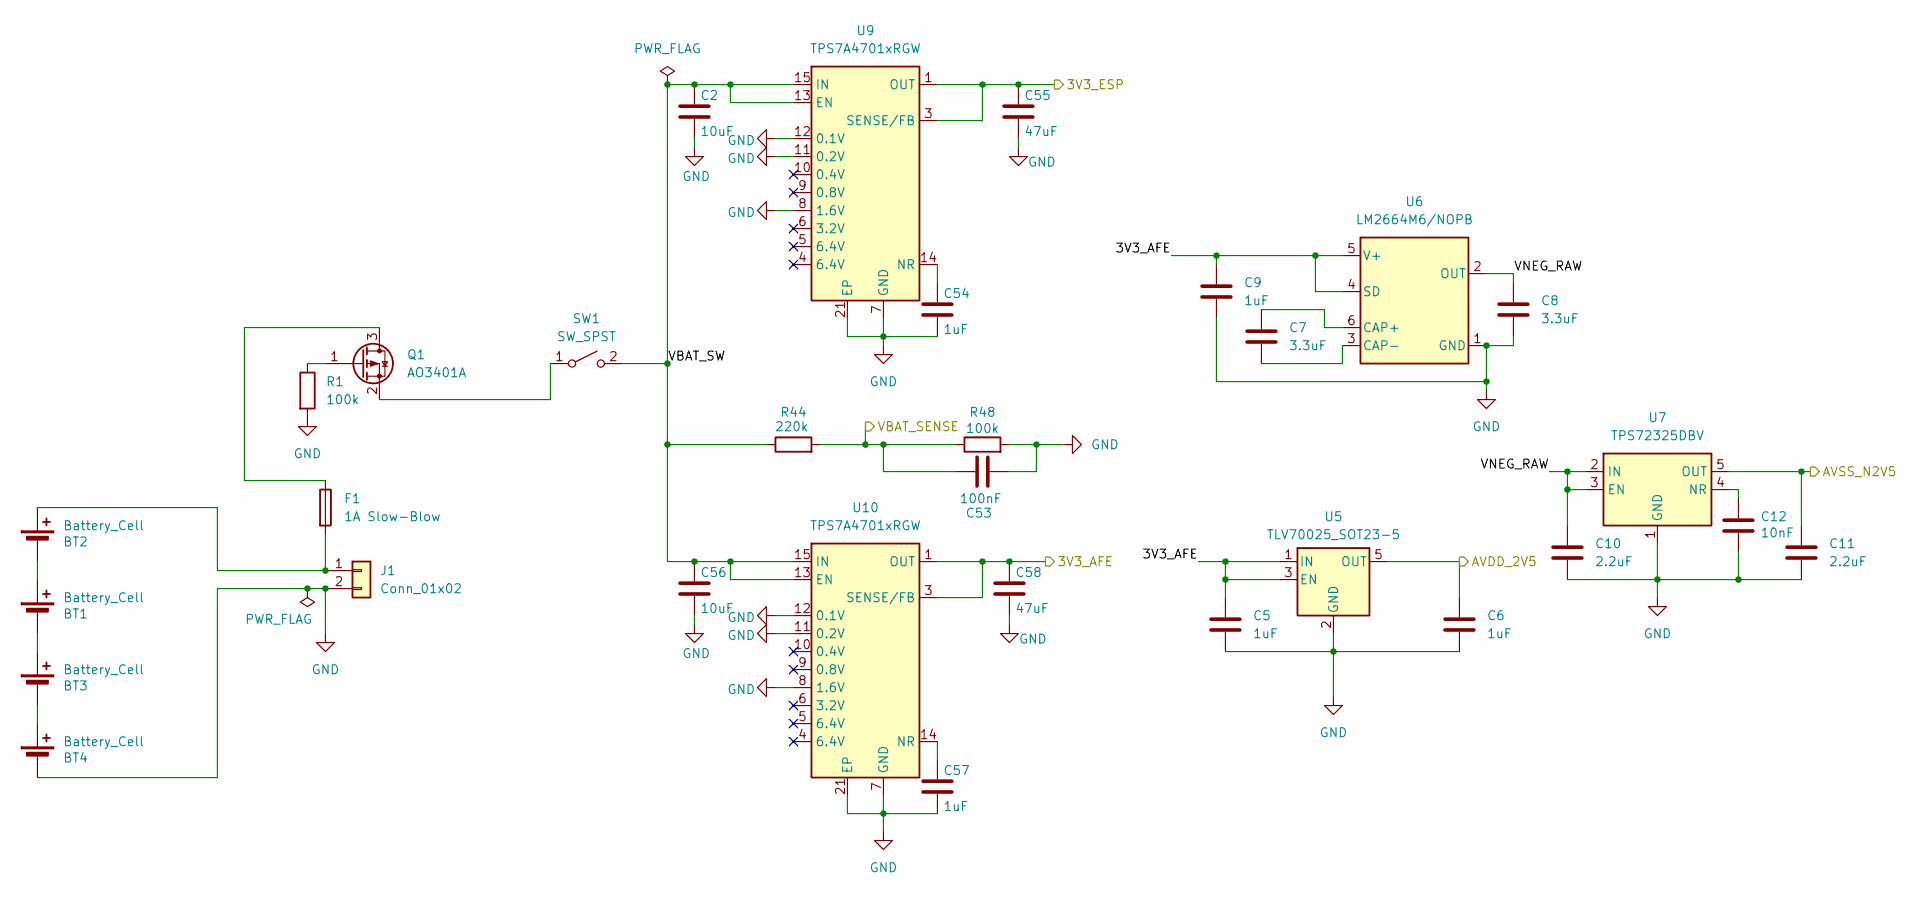
[picture p13: schematic Power_Supply.kicad_sch]

Parts:
BT1, BT2, BT3, BT4: Battery_Cell
C2, C56: 10uF; C_1206_3216Metric; Tolerance 10%; Voltage rating 16V; MPN GRM31CR71C106KAC7L
C5, C6, C9, C54, C57: 1uF; C_0805_2012Metric; Tolerance 10%; Voltage rating 25V; MPN C2012X7R1E105K125AB
C7, C8: 3.3uF; C_1206_3216Metric; Tolerance 10%; Voltage rating 25V; MPN C1206C335K3RACTU
C10, C11: 2.2uF; C_0805_2012Metric; Tolerance 10%; Voltage rating 50V; MPN C2012X7R1H225K125AC
C12: 10nF; C_0603_1608Metric; Tolerance 10%; Voltage rating 100V; MPN GRM188R72A103KA01D
C53: 100nF; C_0603_1608Metric; Tolerance 10%; Voltage rating 100V; MPN GRM188R72A104KA35D
C55, C58: 47uF; C_1210_3225Metric; Tolerance 10%; Voltage rating 16V; MPN CL32A476KOJNNNE
F1: 1A Slow-Blow; SF-1206S100-2; MPN SF-1206S100-2
J1: Conn_01x02; JST_PH_B2B-PH-K_1x02_P2.00mm_Vertical; MPN B2B-PH-K-S(LF)(SN)
Q1: AO3401A; SOT-23; MPN AO3401A
R1, R48: 100k; R_0603_1608Metric; Power Rating 0.1 W; Tolerance ±1%; MPN RC0603FR-07100KL
R44: 220k; R_0603_1608Metric; Power Rating 0.1 W; Tolerance ±1%; MPN RC0603FR-07220KL
SW1: SW_SPST; SW_CW_GPTS203211B; MPN GPTS203211B
U5: TLV70025_SOT23-5; SOT-23-5; MPN TLV70025DDCR
U6: LM2664M6/NOPB; SOT-23-6; MPN LM2664M6/NOPB
U7: TPS72325DBV; SOT-23-5; MPN TPS72325DBVR
U9, U10: TPS7A4701xRGW; Texas_RGW0020A_VQFN-20-1EP_5x5mm_P0.65mm_EP3.15x3.15mm_Ther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; MPN TPS7A4701RGWR

Connections:
/ADS1299_AFE/AVDD_2V5: C6.1, U5.5 (OUT); also elsewhere on the board
/ADS1299_AFE/AVSS_N2V5: C11.1, U7.5 (OUT); also elsewhere on the board
/ADS1299_AFE/DVDD_3V3: C5.1, C9.1, C58.1, U5.1 (IN), U5.3 (EN), U6.4 (SD), U6.5 (V+), U10.1 (OUT), U10.3 (SENSE/FB), U10.20 (OUT); also elsewhere on the board
/ESP32_Interface/ESP_3V3: C55.1, U9.1 (OUT), U9.3 (SENSE/FB), U9.20 (OUT); also elsewhere on the board
/ESP32_Interface/ESP_Battery_Monitor: C53.1, R44.2, R48.1; also elsewhere on the board
/Power_Supply/VBAT_SW: C2.1, C56.1, R44.1, SW1.2 (B), U9.13 (EN), U9.15 (IN), U9.16 (IN), U10.13 (EN), U10.15 (IN), U10.16 (IN)
/Power_Supply/VNEG_RAW: C8.1, C10.1, U6.2 (OUT), U7.2 (IN), U7.3 (EN)
GND: BT4.2 (-), C2.2, C5.2, C6.2, C8.2, C9.2, C10.2, C11.2, C12.2, C53.2, C54.2, C55.2, C56.2, C57.2, C58.2, J1.2, R1.2, R48.2, U5.2 (GND), U6.1 (GND), U7.1 (GND), U9.7 (GND), U9.8 (1.6V), U9.11 (0.2V), U9.12 (0.1V), U9.21 (EP), U10.7 (GND), U10.8 (1.6V), U10.11 (0.2V), U10.12 (0.1V), U10.21 (EP); also elsewhere on the board
unnamed: BT1.1 (+), BT2.2 (-)
unnamed: BT1.2 (-), BT3.1 (+)
unnamed: BT3.2 (-), BT4.1 (+)
unnamed: BT2.1 (+), F1.2, J1.1
unnamed: F1.1, Q1.3 (D)
unnamed: Q1.1 (G), R1.1
unnamed: Q1.2 (S), SW1.1 (A)
unnamed: C7.1, U6.6 (CAP+)
unnamed: C7.2, U6.3 (CAP-)
unnamed: C12.1, U7.4 (NR)
unnamed: C54.1, U9.14 (NR)
unnamed: C57.1, U10.14 (NR)

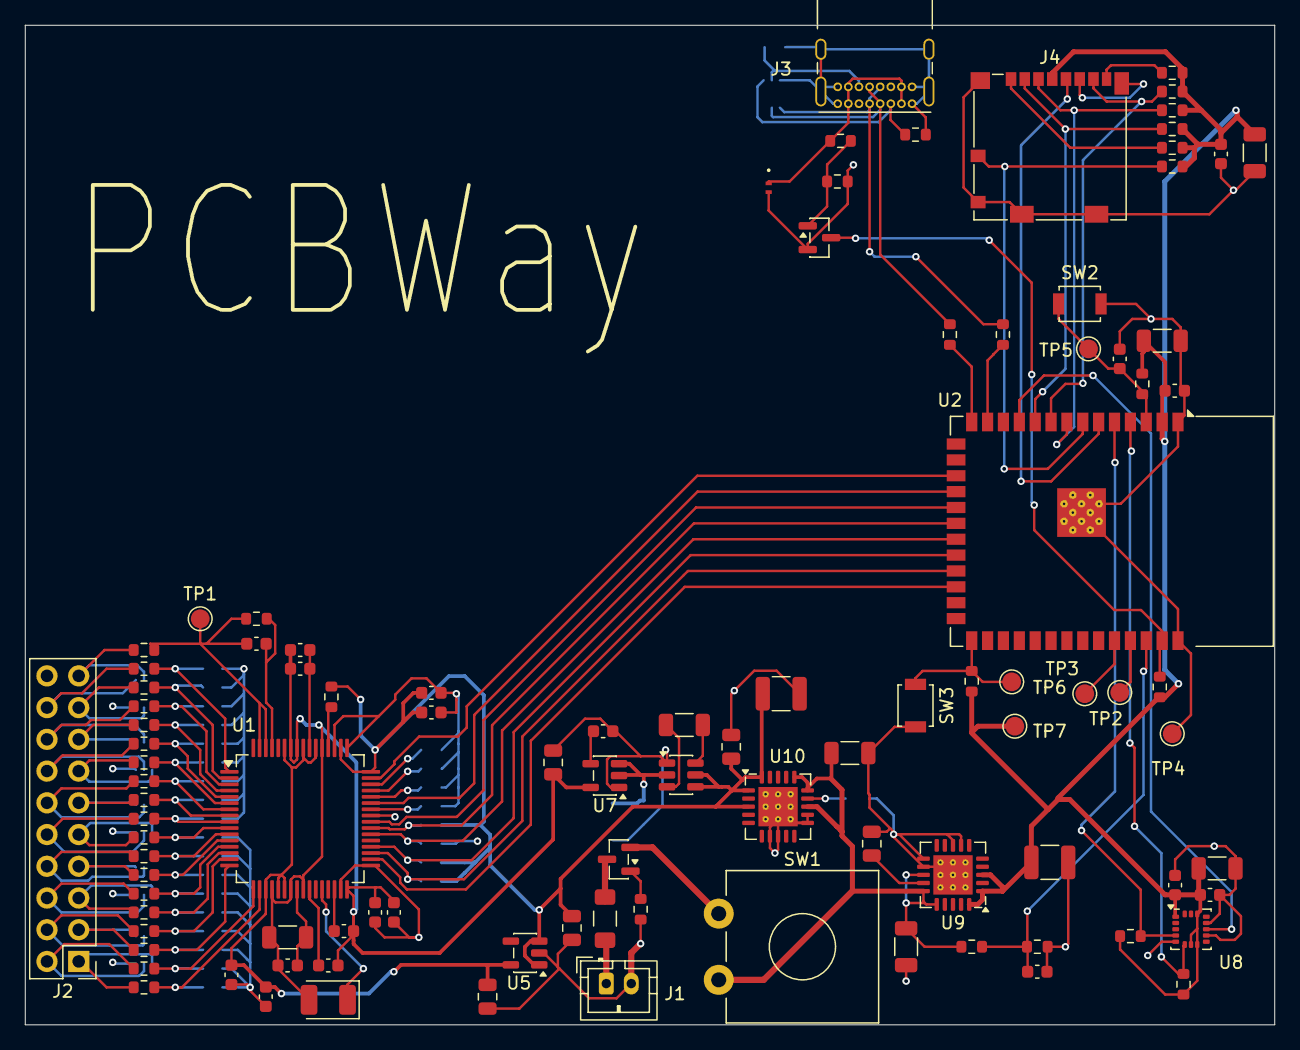
[picture p14: board EEG_PROJECT.kicad_pcb from above]

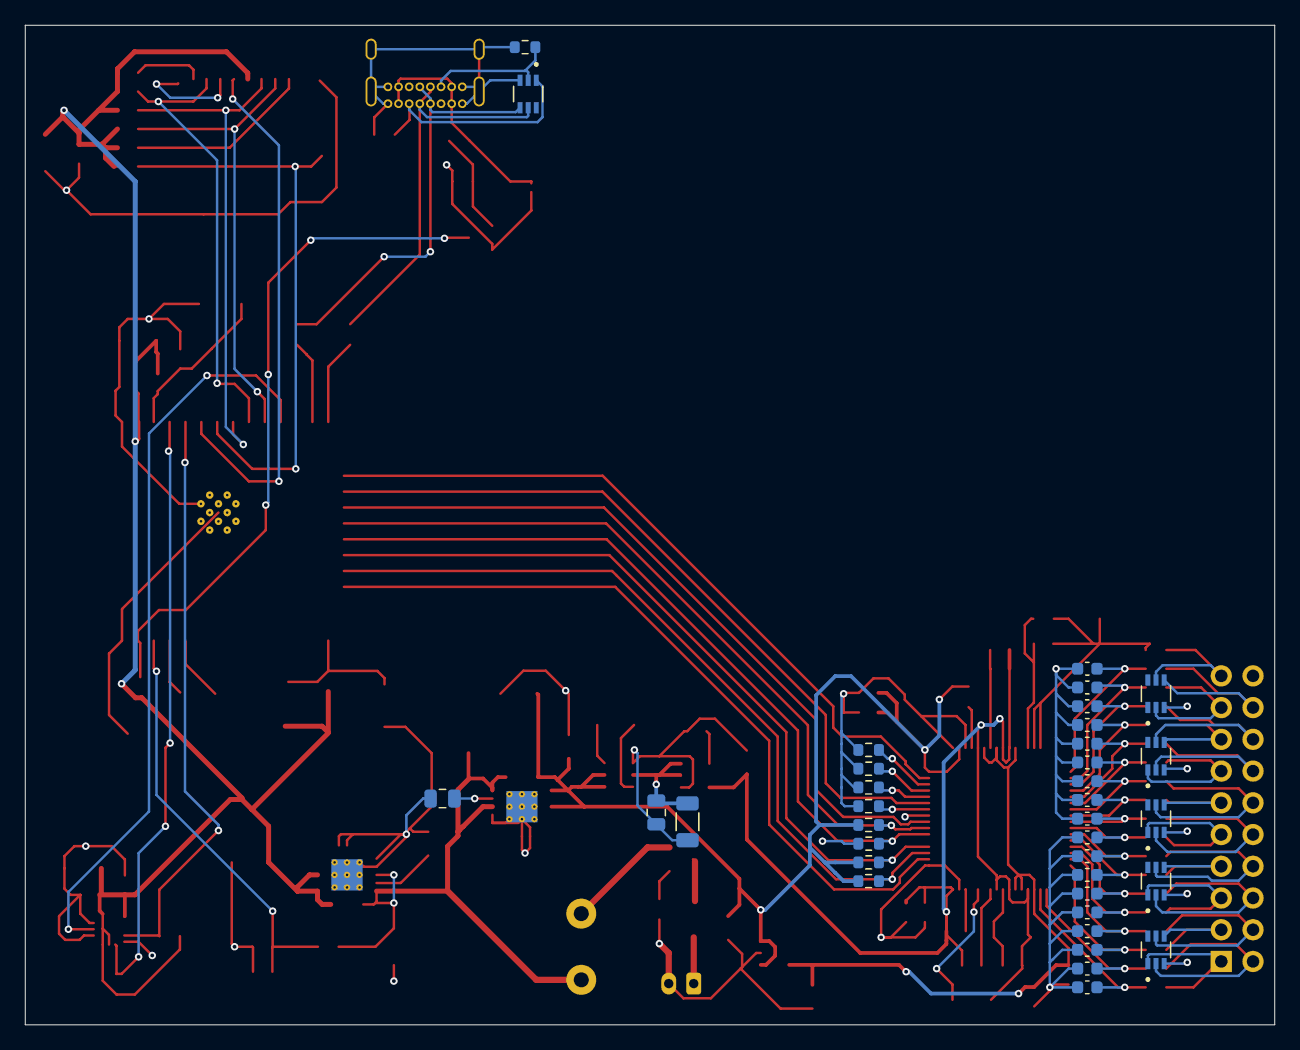
[picture p15: board EEG_PROJECT.kicad_pcb from below]

Board: 4 copper layers, 100.0 x 80.0 mm, 136 parts (36 on the bottom side), 97 nets.
